UncleCJ/ferris/0.2/high/ferris.kicad_pcb

## KiCad design 0.2/high/ferris.kicad_pcb (2023-08-07)

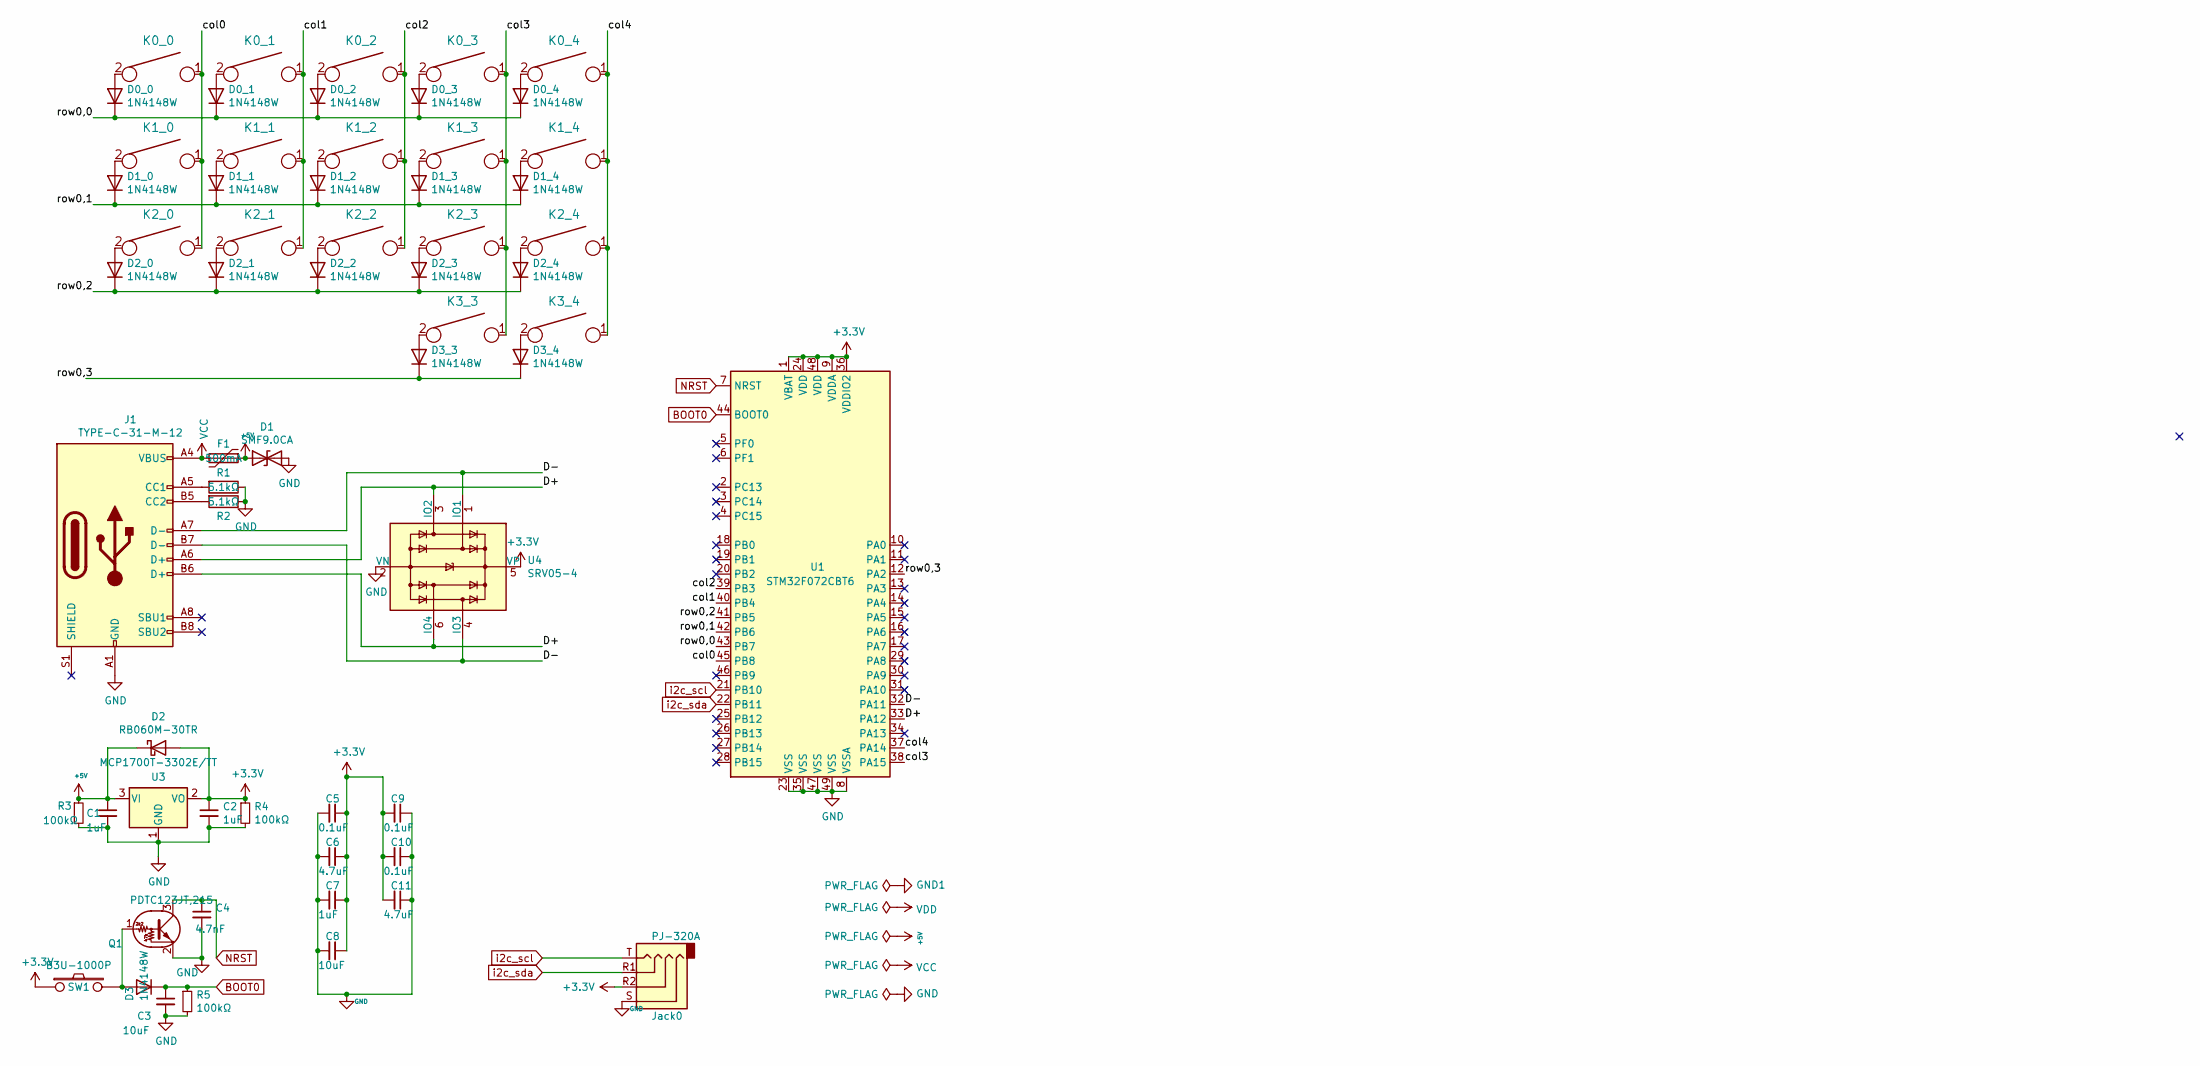
[picture p1: schematic ferris.kicad_sch]

Parts:
C1, C2, C7: 1uF; C_0805_2012Metric_Pad1.15x1.40mm_HandSolder; Part Name Capacitor; LCSC Part C28323
C3, C8: 10uF; C_0805_2012Metric_Pad1.15x1.40mm_HandSolder; Part Name Capacitor; LCSC Part C17024
C4: 4.7nF; C_0805_2012Metric_Pad1.15x1.40mm_HandSolder; Part Name Capacitor; LCSC Part C717014
C5, C9, C10: 0.1uF; C_0805_2012Metric_Pad1.15x1.40mm_HandSolder; Part Name Capacitor; LCSC Part C49678
C6, C11: 4.7uF; C_0805_2012Metric_Pad1.15x1.40mm_HandSolder; Part Name Capacitor; LCSC Part C87998
D0_0, D0_1, D0_2, D0_3, D0_4, D1_0, D1_1, D1_2, D1_3, D1_4, D2_0, D2_1, D2_2, D2_3, D2_4, D3, D3_3, D3_4: 1N4148W; D_SOD-123; Part Name Diode; LCSC Part C81598
D1: SMF9.0CA; D_SOD-123; Part Name Bidirectional Diode; LCSC Part C435473
D2: RB060M-30TR; D_SOD-123; Part Name Schottky Barrier Diode; LCSC Part C559324
F1: 500mA; Fuse_1206_3216Metric; Part Name Polyfuse; LCSC Part C151162
J1: TYPE-C-31-M-12; USB_C_Receptacle_HRO_TYPE-C-31-M-12; Part Name USB C; LCSC Part C165948
Jack0: PJ-320A; TRRS-PJ-320A; Part Name TRRS Jack; LCSC Part C12569
K0_0, K0_1, K0_2, K0_3, K0_4, K1_0, K1_1, K1_2, K1_3, K1_4, K2_0, K2_1, K2_2, K2_3, K2_4, K3_3, K3_4: KEYSW; MX; Part Name Key; JLCPCB BOM false
Q1: PDTC123JT,215; SOT-23; Part Name NPN Transistor; LCSC Part C406040
R1, R2: 5.1kΩ; R_0805_2012Metric_Pad1.15x1.40mm_HandSolder; Part Name Resistor; LCSC Part C27834
R3, R4, R5: 100kΩ; R_0805_2012Metric_Pad1.15x1.40mm_HandSolder; Part Name Resistor; LCSC Part C149504
SW1: B3U-1000P; SW_SPST_B3U-1000P; Part Name Reset; LCSC Part C231329
U1: STM32F072CBT6; Dual_MCU_QFP_QFN_48_with_breakout_pins; Part Name MCU; LCSC Part C81720
U3: MCP1700T-3302E/TT; SOT-23; Part Name Dropout Regulator; LCSC Part C39051
U4: SRV05-4; SOT-23-6; Part Name TVS Diode Array; LCSC Part C558418

Connections:
+3V3: C2.1, C5.1, C6.1, C7.1, C8.1, C9.2, C10.2, C11.2, D2.2 (A), Jack0.R2, R4.1, SW1.1, U1.1 (VBAT), U1.9 (VDDA), U1.24 (VDD), U1.36 (VDDIO2), U1.48 (VDD), U3.2 (VO), U4.5 (VP)
+5V: C1.1, D1.1 (A1), D2.1 (K), F1.1, R3.1, U3.3 (VI)
/D+: J1.A6 (D+), J1.B6 (D+), U1.33 (PA12), U4.3 (IO2), U4.6 (IO4)
/D-: J1.A7 (D-), J1.B7 (D-), U1.32 (PA11), U4.1 (IO1), U4.4 (IO3)
/col0: K0_0.1, K1_0.1, K2_0.1, U1.45 (PB8)
/col1: K0_1.1, K1_1.1, K2_1.1, U1.40 (PB4)
/col2: K0_2.1, K1_2.1, K2_2.1, U1.39 (PB3)
/col3: K0_3.1, K1_3.1, K2_3.1, K3_3.1, U1.38 (PA15)
/col4: K0_4.1, K1_4.1, K2_4.1, K3_4.1, U1.37 (PA14)
/row0,0: D0_0.1 (K), D0_1.1 (K), D0_2.1 (K), D0_3.1 (K), D0_4.1 (K), U1.43 (PB7)
/row0,1: D1_0.1 (K), D1_1.1 (K), D1_2.1 (K), D1_3.1 (K), D1_4.1 (K), U1.42 (PB6)
/row0,2: D2_0.1 (K), D2_1.1 (K), D2_2.1 (K), D2_3.1 (K), D2_4.1 (K), U1.41 (PB5)
/row0,3: D3_3.1 (K), D3_4.1 (K), U1.12 (PA2)
BOOT0: C3.1, D3.1 (K), R5.1, U1.44 (BOOT0)
GND: C1.2, C2.2, C3.2, C4.2, C5.2, C6.2, C7.2, C8.2, C9.1, C10.1, C11.1, D1.2 (A2), J1.A1 (GND), J1.A12 (GND), J1.B1 (GND), J1.B12 (GND), Jack0.S, Q1.2 (E), R1.1, R2.1, R3.2, R4.2, R5.2, U1.8 (VSSA), U1.23 (VSS), U1.35 (VSS), U1.47 (VSS), U1.49 (VSS), U3.1 (GND), U4.2 (VN)
NRST: C4.1, Q1.3 (C), U1.7 (NRST)
unnamed: D0_0.2 (A), K0_0.2
unnamed: D0_1.2 (A), K0_1.2
unnamed: D0_2.2 (A), K0_2.2
unnamed: D0_3.2 (A), K0_3.2
unnamed: D0_4.2 (A), K0_4.2
unnamed: D1_0.2 (A), K1_0.2
unnamed: D1_1.2 (A), K1_1.2
unnamed: D1_2.2 (A), K1_2.2
unnamed: D1_3.2 (A), K1_3.2
unnamed: D1_4.2 (A), K1_4.2
unnamed: D2_0.2 (A), K2_0.2
unnamed: D2_1.2 (A), K2_1.2
unnamed: D2_2.2 (A), K2_2.2
unnamed: D2_3.2 (A), K2_3.2
unnamed: D2_4.2 (A), K2_4.2
unnamed: D3.2 (A), Q1.1 (B), SW1.2
unnamed: D3_3.2 (A), K3_3.2
unnamed: D3_4.2 (A), K3_4.2
unnamed: J1.A5 (CC1), R1.2
unnamed: J1.B5 (CC2), R2.2
VCC: F1.2, J1.A4 (VBUS), J1.A9 (VBUS), J1.B4 (VBUS), J1.B9 (VBUS)
i2c_scl: Jack0.T, U1.21 (PB10)
i2c_sda: Jack0.R1, U1.22 (PB11)

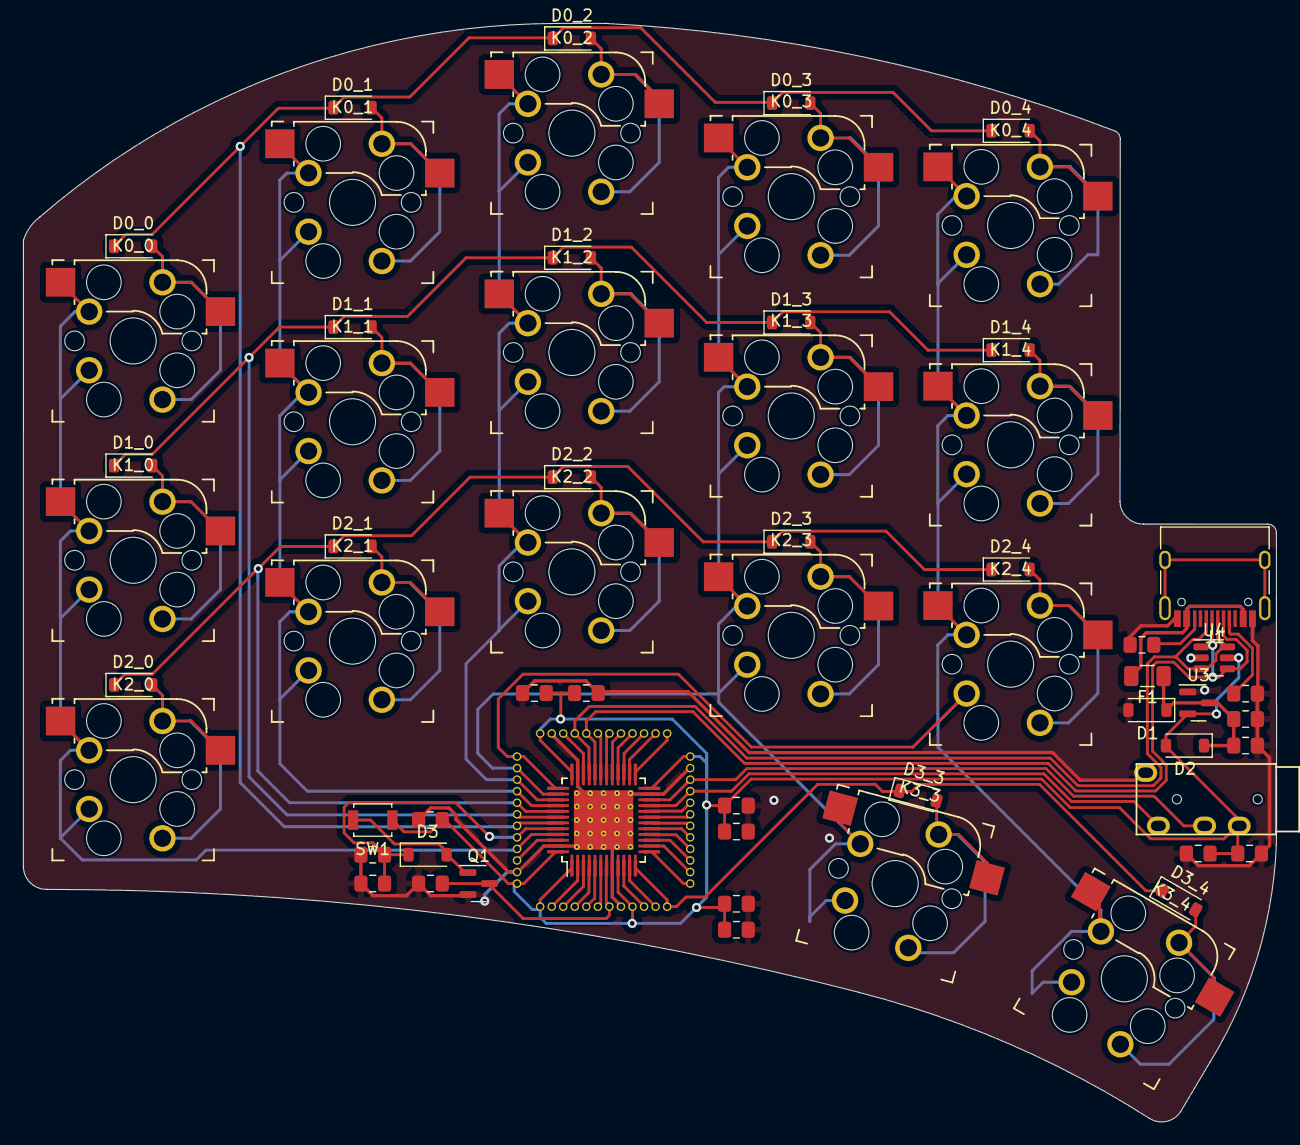
[picture p2: board 0.2/high/ferris.kicad_pcb from above]

Board: 2 copper layers, 108.5 x 95.2 mm, 61 parts (0 on the bottom side), 39 nets.
