UncleCJ/ferris/0.2/bling/ferris.kicad_pcb

## KiCad design 0.2/bling/ferris.kicad_pcb (2023-08-05)

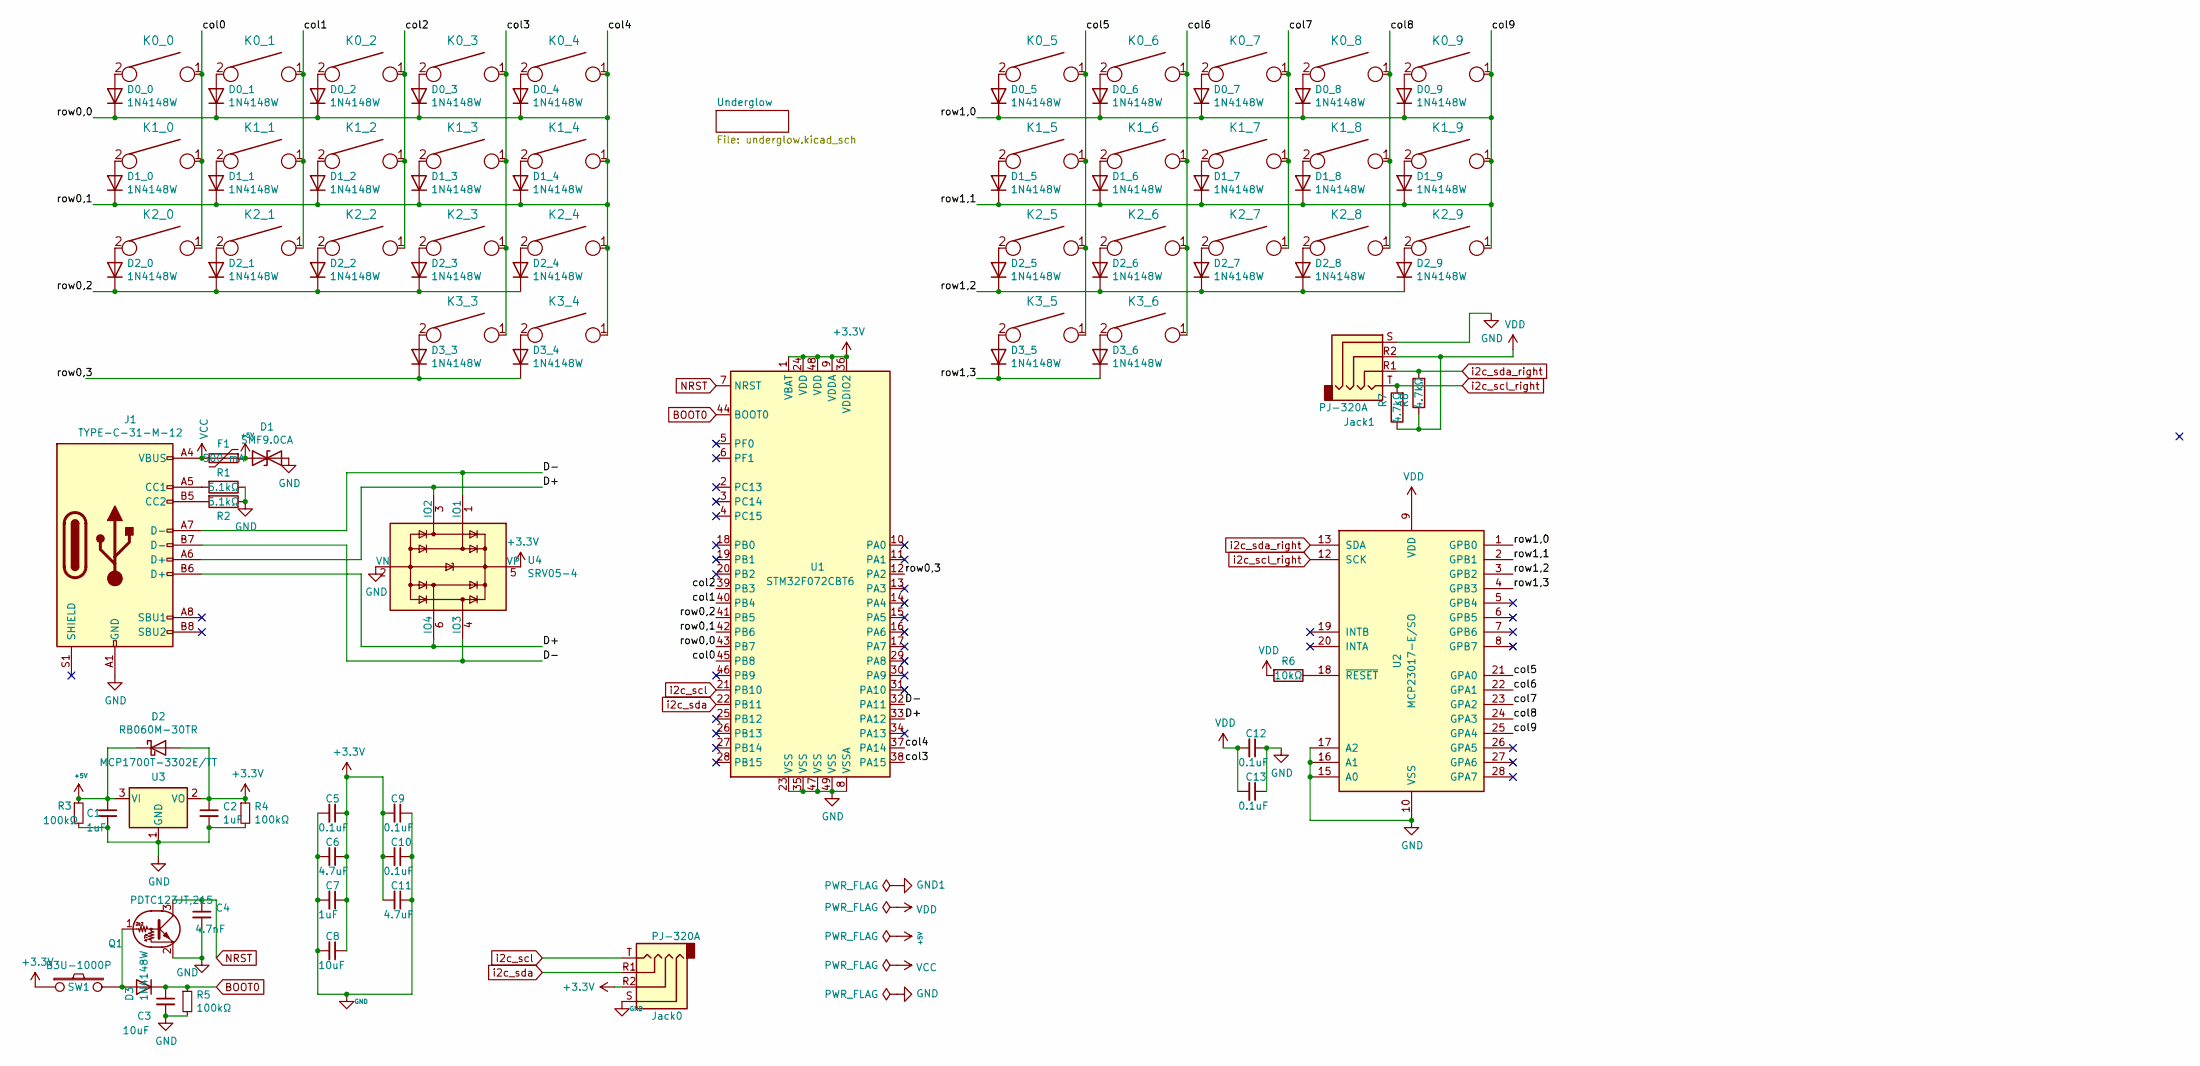
[picture p3: schematic ferris.kicad_sch]

Parts:
C1, C2, C7: 1uF; C_0805_2012Metric_Pad1.15x1.40mm_HandSolder; Part Name Capacitor; LCSC Part C28323
C3, C8: 10uF; C_0805_2012Metric_Pad1.15x1.40mm_HandSolder; Part Name Capacitor; LCSC Part C17024
C4: 4.7nF; C_0805_2012Metric_Pad1.15x1.40mm_HandSolder; Part Name Capacitor; LCSC Part C717014
C5, C9, C10, C12, C13: 0.1uF; C_0805_2012Metric_Pad1.15x1.40mm_HandSolder; Part Name Capacitor; LCSC Part C49678
C6, C11: 4.7uF; C_0805_2012Metric_Pad1.15x1.40mm_HandSolder; Part Name Capacitor; LCSC Part C87998
D0_0, D0_1, D0_2, D0_3, D0_4, D0_5, D0_6, D0_7, D0_8, D0_9, D1_0, D1_1, D1_2, D1_3, D1_4, D1_5, D1_6, D1_7, D1_8, D1_9, D2_0, D2_1, D2_2, D2_3, D2_4, D2_5, D2_6, D2_7, D2_8, D2_9, D3, D3_3, D3_4, D3_5, D3_6: 1N4148W; D_SOD-123; Part Name Diode; LCSC Part C81598
D1: SMF9.0CA; D_SOD-123; Part Name Bidirectional Diode; LCSC Part C435473
D2: RB060M-30TR; D_SOD-123; Part Name Schottky Barrier Diode; LCSC Part C559324
F1: 500 mA; Fuse_1206_3216Metric; Part Name Polyfuse; LCSC Part C151162
J1: TYPE-C-31-M-12; USB_C_Receptacle_HRO_TYPE-C-31-M-12; Part Name USB C; LCSC Part C165948
Jack0, Jack1: PJ-320A; TRRS-PJ-320A; Part Name TRRS Jack; LCSC Part C12569
K0_0, K0_1, K0_2, K0_3, K0_4, K0_5, K0_6, K0_7, K0_8, K0_9, K1_0, K1_1, K1_2, K1_3, K1_4, K1_5, K1_6, K1_7, K1_8, K1_9, K2_0, K2_1, K2_2, K2_3, K2_4, K2_5, K2_6, K2_7, K2_8, K2_9, K3_3, K3_4, K3_5, K3_6: KEYSW; Choc_PG1350_Choc_Spacing; Part Name Key; JLCPCB BOM false
Q1: PDTC123JT,215; SOT-23; Part Name NPN Transistor; LCSC Part C406040
R1, R2: 5.1kΩ; R_0805_2012Metric_Pad1.15x1.40mm_HandSolder; Part Name Resistor; LCSC Part C27834
R3, R4, R5: 100kΩ; R_0805_2012Metric_Pad1.15x1.40mm_HandSolder; Part Name Resistor; LCSC Part C149504
R6: 10kΩ; R_0805_2012Metric_Pad1.15x1.40mm_HandSolder; Part Name Resistor; LCSC Part C17414
R7, R8: 4.7kΩ; R_0805_2012Metric_Pad1.15x1.40mm_HandSolder; Part Name Resistor; LCSC Part C17673
SW1: B3U-1000P; SW_SPST_B3U-1000P; Part Name Reset; LCSC Part C231329
U1: STM32F072CBT6; Dual_MCU_QFP_QFN_48_with_breakout_pins; Part Name MCU; LCSC Part C81720
U2: MCP23017-E/SO; SOIC-28W_7.5x17.9mm_P1.27mm; Part Name I/O Expander; LCSC Part C47023
U3: MCP1700T-3302E/TT; SOT-23; Part Name Dropout Regulator; LCSC Part C39051
U4: SRV05-4; SOT-23-6; Part Name TVS Diode Array; LCSC Part C558418

Connections:
+3V3: C2.1, C5.1, C6.1, C7.1, C8.1, C9.2, C10.2, C11.2, D2.2 (A), Jack0.R2, R4.1, SW1.1, U1.1 (VBAT), U1.9 (VDDA), U1.24 (VDD), U1.36 (VDDIO2), U1.48 (VDD), U3.2 (VO), U4.5 (VP); also elsewhere on the board
+5V: C1.1, D1.1 (A1), D2.1 (K), F1.1, R3.1, U3.3 (VI)
/D+: J1.A6 (D+), J1.B6 (D+), U1.33 (PA12), U4.3 (IO2), U4.6 (IO4)
/D-: J1.A7 (D-), J1.B7 (D-), U1.32 (PA11), U4.1 (IO1), U4.4 (IO3)
/col0: K0_0.1, K1_0.1, K2_0.1, U1.45 (PB8)
/col1: K0_1.1, K1_1.1, K2_1.1, U1.40 (PB4)
/col2: K0_2.1, K1_2.1, K2_2.1, U1.39 (PB3)
/col3: K0_3.1, K1_3.1, K2_3.1, K3_3.1, U1.38 (PA15)
/col5: K0_5.1, K1_5.1, K2_5.1, K3_5.1, U2.21 (GPA0)
/col6: K0_6.1, K1_6.1, K2_6.1, K3_6.1, U2.22 (GPA1)
/col7: K0_7.1, K1_7.1, K2_7.1, U2.23 (GPA2)
/col8: K0_8.1, K1_8.1, K2_8.1, U2.24 (GPA3)
/row0,2: D2_0.1 (K), D2_1.1 (K), D2_2.1 (K), D2_3.1 (K), D2_4.1 (K), U1.41 (PB5)
/row0,3: D3_3.1 (K), D3_4.1 (K), U1.12 (PA2)
/row1,2: D2_5.1 (K), D2_6.1 (K), D2_7.1 (K), D2_8.1 (K), D2_9.1 (K), U2.3 (GPB2)
/row1,3: D3_5.1 (K), D3_6.1 (K), U2.4 (GPB3)
BOOT0: C3.1, D3.1 (K), R5.1, U1.44 (BOOT0)
GND: C1.2, C2.2, C3.2, C4.2, C5.2, C6.2, C7.2, C8.2, C9.1, C10.1, C11.1, C12.1, C13.1, D1.2 (A2), J1.A1 (GND), J1.A12 (GND), J1.B1 (GND), J1.B12 (GND), Jack0.S, Jack1.S, Q1.2 (E), R1.1, R2.1, R3.2, R4.2, R5.2, U1.8 (VSSA), U1.23 (VSS), U1.35 (VSS), U1.47 (VSS), U1.49 (VSS), U2.10 (VSS), U2.15 (A0), U2.16 (A1), U2.17 (A2), U3.1 (GND), U4.2 (VN); also elsewhere on the board
NRST: C4.1, Q1.3 (C), U1.7 (NRST)
unnamed: D0_0.2 (A), K0_0.2
unnamed: D0_1.2 (A), K0_1.2
unnamed: D0_2.2 (A), K0_2.2
unnamed: D0_3.2 (A), K0_3.2
unnamed: D0_4.2 (A), K0_4.2
unnamed: D0_5.2 (A), K0_5.2
unnamed: D0_6.2 (A), K0_6.2
unnamed: D0_7.2 (A), K0_7.2
unnamed: D0_8.2 (A), K0_8.2
unnamed: D0_9.2 (A), K0_9.2
unnamed: D1_0.2 (A), K1_0.2
unnamed: D1_1.2 (A), K1_1.2
unnamed: D1_2.2 (A), K1_2.2
unnamed: D1_3.2 (A), K1_3.2
unnamed: D1_4.2 (A), K1_4.2
unnamed: D1_5.2 (A), K1_5.2
unnamed: D1_6.2 (A), K1_6.2
unnamed: D1_7.2 (A), K1_7.2
unnamed: D1_8.2 (A), K1_8.2
unnamed: D1_9.2 (A), K1_9.2
unnamed: D2_0.2 (A), K2_0.2
unnamed: D2_1.2 (A), K2_1.2
unnamed: D2_2.2 (A), K2_2.2
unnamed: D2_3.2 (A), K2_3.2
unnamed: D2_4.2 (A), K2_4.2
unnamed: D2_5.2 (A), K2_5.2
unnamed: D2_6.2 (A), K2_6.2
unnamed: D2_7.2 (A), K2_7.2
unnamed: D2_8.2 (A), K2_8.2
unnamed: D2_9.2 (A), K2_9.2
unnamed: D3.2 (A), Q1.1 (B), SW1.2
unnamed: D3_3.2 (A), K3_3.2
unnamed: D3_4.2 (A), K3_4.2
unnamed: D3_5.2 (A), K3_5.2
unnamed: D3_6.2 (A), K3_6.2
unnamed: J1.A5 (CC1), R1.2
unnamed: J1.B5 (CC2), R2.2
unnamed: R6.1, U2.18 (~RESET)
VCC: F1.2, J1.A4 (VBUS), J1.A9 (VBUS), J1.B4 (VBUS), J1.B9 (VBUS)
VDD: C12.2, C13.2, Jack1.R2, R6.2, R7.1, R8.1, U2.9 (VDD); also elsewhere on the board
i2c_scl: Jack0.T, U1.21 (PB10); also elsewhere on the board
i2c_scl_right: Jack1.T, R7.2, U2.12 (SCK); also elsewhere on the board
i2c_sda: Jack0.R1, U1.22 (PB11); also elsewhere on the board
i2c_sda_right: Jack1.R1, R8.2, U2.13 (SDA); also elsewhere on the board

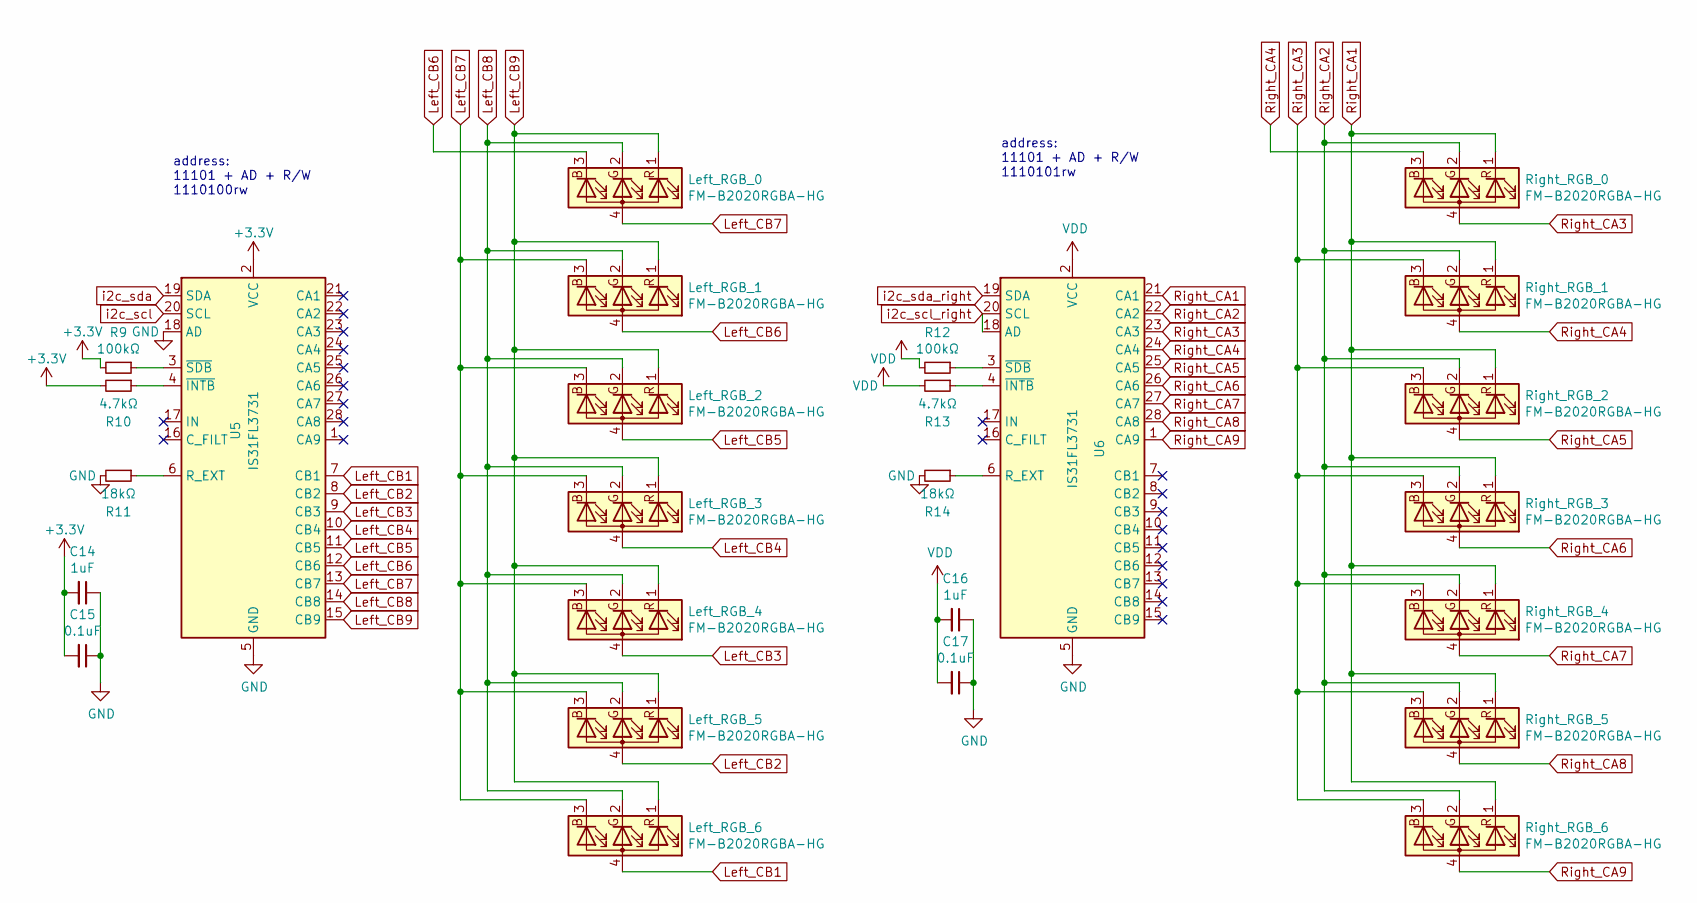
[picture p4: schematic underglow.kicad_sch]

Parts:
C14, C16: 1uF; C_0805_2012Metric_Pad1.15x1.40mm_HandSolder; Part Name Capacitor; LCSC Part C28323
C15, C17: 0.1uF; C_0805_2012Metric_Pad1.15x1.40mm_HandSolder; Part Name Capacitor; LCSC Part C49678
Left_RGB_0, Left_RGB_1, Left_RGB_2, Left_RGB_3, Left_RGB_4, Left_RGB_5, Left_RGB_6: FM-B2020RGBA-HG; LED_RGB_FM-B2020RGBA-HG; Part Name RGB LED; LCSC Part C108793
R9, R12: 100kΩ; R_0805_2012Metric_Pad1.15x1.40mm_HandSolder; Part Name Resistor; LCSC Part C149504
R10, R13: 4.7kΩ; R_0805_2012Metric_Pad1.15x1.40mm_HandSolder; Part Name Resistor; LCSC Part C17673
R11, R14: 18kΩ; R_0805_2012Metric_Pad1.15x1.40mm_HandSolder; Part Name Resistor; LCSC Part C25622
Right_RGB_0, Right_RGB_1, Right_RGB_2, Right_RGB_3, Right_RGB_4, Right_RGB_5, Right_RGB_6: FM-B2020RGBA-HG; LED_RGB_FM-B2020RGBA-HG; Part Name RGB LED; LCSC Part C108793
U5, U6: IS31FL3731; QFN-28-1EP_4x4mm_P0.4mm_EP2.3x2.3mm_ThermalVias; Part Name LED Driver; LCSC Part C191206

Connections:
+3V3: C14.2, C15.2, R9.2, R10.2, U5.2 (VCC); also elsewhere on the board
GND: C14.1, C15.1, C16.1, C17.1, R11.2, R14.2, U5.5 (GND), U5.18 (AD), U5.29 (GND), U6.5 (GND), U6.29 (GND); also elsewhere on the board
Left_CB1: Left_RGB_6.4 (A), U5.7 (CB1)
Left_CB2: Left_RGB_5.4 (A), U5.8 (CB2)
Left_CB3: Left_RGB_4.4 (A), U5.9 (CB3)
Left_CB4: Left_RGB_3.4 (A), U5.10 (CB4)
Left_CB5: Left_RGB_2.4 (A), U5.11 (CB5)
Left_CB6: Left_RGB_0.3 (BK), Left_RGB_1.4 (A), U5.12 (CB6)
Left_CB7: Left_RGB_0.4 (A), Left_RGB_1.3 (BK), Left_RGB_2.3 (BK), Left_RGB_3.3 (BK), Left_RGB_4.3 (BK), Left_RGB_5.3 (BK), Left_RGB_6.3 (BK), U5.13 (CB7)
Left_CB8: Left_RGB_0.2 (GK), Left_RGB_1.2 (GK), Left_RGB_2.2 (GK), Left_RGB_3.2 (GK), Left_RGB_4.2 (GK), Left_RGB_5.2 (GK), Left_RGB_6.2 (GK), U5.14 (CB8)
Left_CB9: Left_RGB_0.1 (RK), Left_RGB_1.1 (RK), Left_RGB_2.1 (RK), Left_RGB_3.1 (RK), Left_RGB_4.1 (RK), Left_RGB_5.1 (RK), Left_RGB_6.1 (RK), U5.15 (CB9)
unnamed: R9.1, U5.3 (~SDB)
unnamed: R10.1, U5.4 (~INTB)
unnamed: R11.1, U5.6 (R_EXT)
unnamed: R12.1, U6.3 (~SDB)
unnamed: R13.1, U6.4 (~INTB)
unnamed: R14.1, U6.6 (R_EXT)
Right_CA1: Right_RGB_0.1 (RK), Right_RGB_1.1 (RK), Right_RGB_2.1 (RK), Right_RGB_3.1 (RK), Right_RGB_4.1 (RK), Right_RGB_5.1 (RK), Right_RGB_6.1 (RK), U6.21 (CA1)
Right_CA2: Right_RGB_0.2 (GK), Right_RGB_1.2 (GK), Right_RGB_2.2 (GK), Right_RGB_3.2 (GK), Right_RGB_4.2 (GK), Right_RGB_5.2 (GK), Right_RGB_6.2 (GK), U6.22 (CA2)
Right_CA3: Right_RGB_0.4 (A), Right_RGB_1.3 (BK), Right_RGB_2.3 (BK), Right_RGB_3.3 (BK), Right_RGB_4.3 (BK), Right_RGB_5.3 (BK), Right_RGB_6.3 (BK), U6.23 (CA3)
Right_CA4: Right_RGB_0.3 (BK), Right_RGB_1.4 (A), U6.24 (CA4)
Right_CA5: Right_RGB_2.4 (A), U6.25 (CA5)
Right_CA6: Right_RGB_3.4 (A), U6.26 (CA6)
Right_CA7: Right_RGB_4.4 (A), U6.27 (CA7)
Right_CA8: Right_RGB_5.4 (A), U6.28 (CA8)
Right_CA9: Right_RGB_6.4 (A), U6.1 (CA9)
VDD: C16.2, C17.2, R12.2, R13.2, U6.2 (VCC); also elsewhere on the board
i2c_scl: U5.20 (SCL); also elsewhere on the board
i2c_scl_right: U6.18 (AD), U6.20 (SCL); also elsewhere on the board
i2c_sda: U5.19 (SDA); also elsewhere on the board
i2c_sda_right: U6.19 (SDA); also elsewhere on the board

Notes on the sheet:
address: 11101 + AD + R/W 1110100rw
address: 11101 + AD + R/W 1110101rw

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
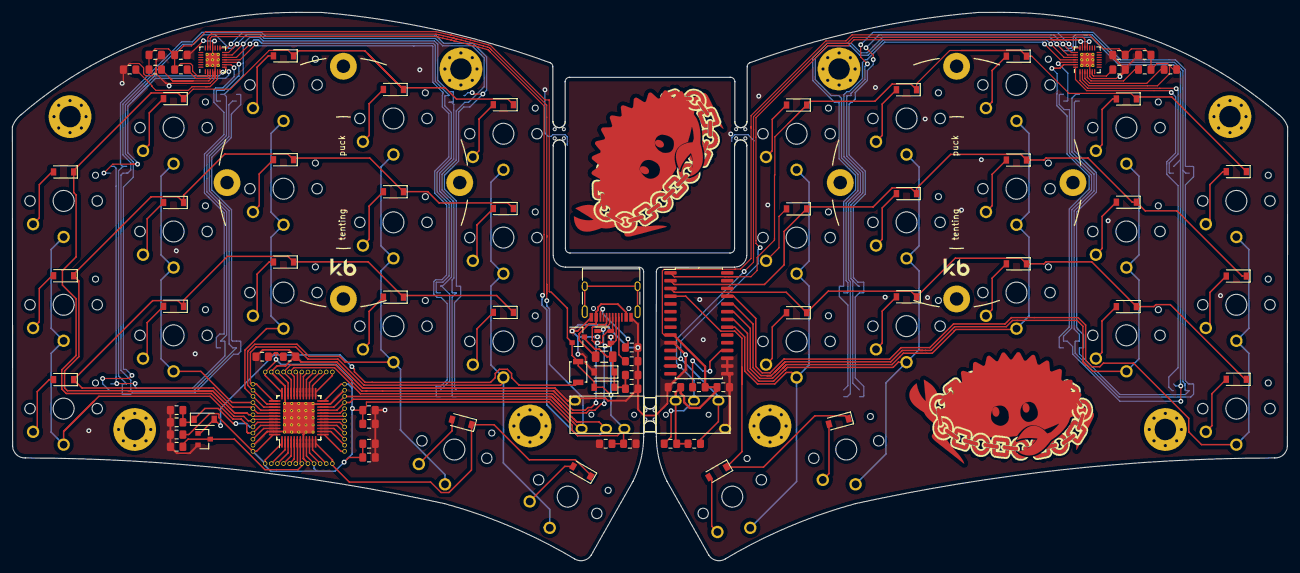
[picture p5: board 0.2/bling/ferris.kicad_pcb from above]

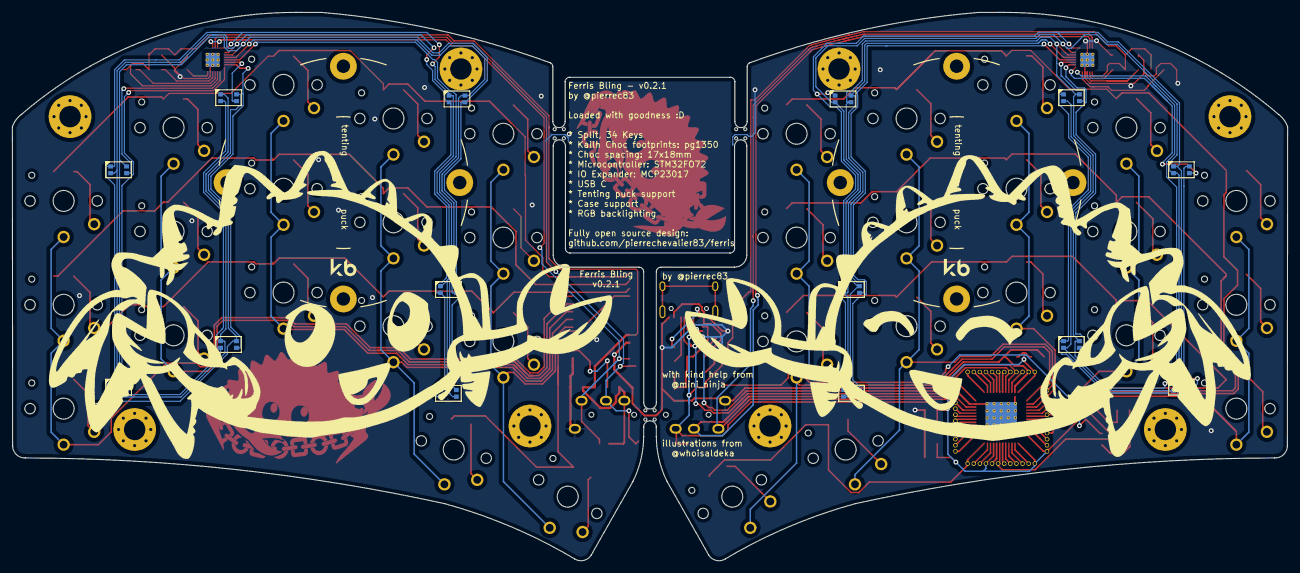
[picture p6: board 0.2/bling/ferris.kicad_pcb from below]

Board: 2 copper layers, 208.8 x 89.8 mm, 131 parts (14 on the bottom side), 93 nets.

Other parts of the board:
mouse-bite-2mm-slot, mouse-bite-2mm-slot#2, mouse-bite-2mm-slot#3: VAL**; mouse-bite-2mm-slot-with-space-for-track
