UncleCJ/ferris/(commit log)

2023-08-05 Add daprice_keyswitches footprint library as submodule
2023-08-05 Begin attempting to fix schematic bug
    [ferris.kicad_pcb, ferris.kicad_sch]
2023-08-05 Attempt to replicate df923a93 Make all mouse bites 5mm
    [ferris.kicad_pcb]
2023-08-05 Update to KiCad 7.0
    ... and prune outdated project files (need to check)
    [ferris.kicad_pcb, ferris.kicad_sch, ferris.sch, underglow.kicad_sch, underglow.sch]
2023-08-07 Again, fix schematic bug connecting rows directly to rightmost column
    [ferris.kicad_sch, underglow.kicad_sch]
2023-08-07 Fix DRC violations down to 163
    Mainly hole clearances, would need to fix the 5mm breakaway tab and perhaps solder mask clearances
    [ferris.kicad_pcb]
2023-08-07 Fix more violations, down to 128
    Mainly updated footprints where needed, kbd library is still not loaded, and various are missing from Resistor/Capacitor_SMD?
    [ferris.kicad_pcb]
2023-08-07 Strip down board
    Fix a couple of 3D models
    Should do this for the complete board
    [ferris.kicad_pcb, ferris.kicad_sch]
2023-08-07 Successfully routed reversible MX footprints
    [ferris.kicad_pcb]
